theNeonTerminal/Custom-ESP32-Remote-Dev-Board/PowerManagement.png

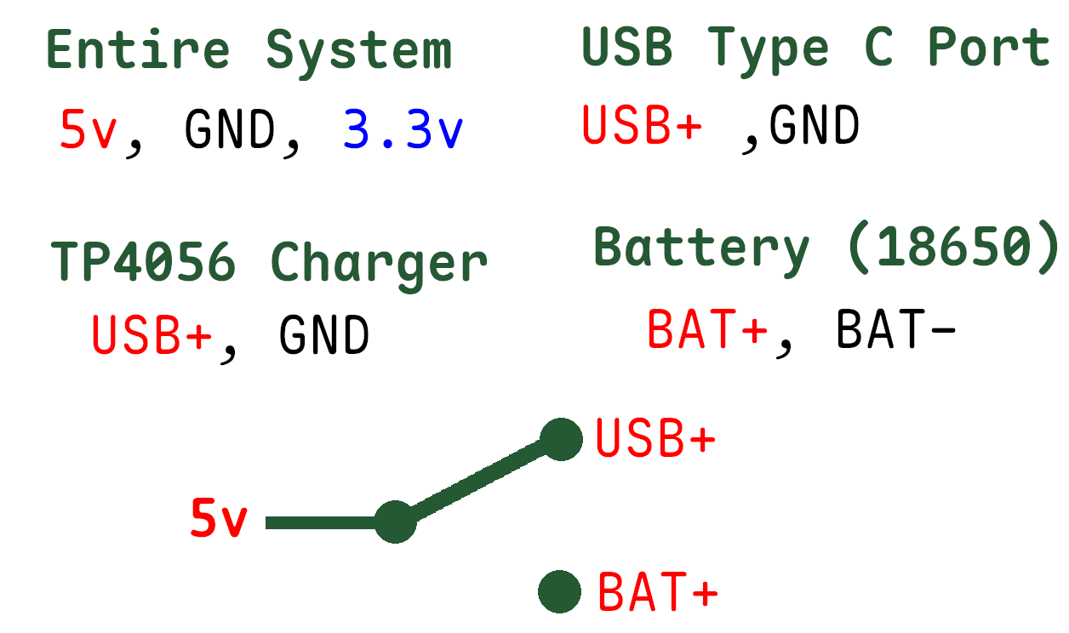
PowerManagement.png
