theNeonTerminal/Custom-ESP32-Remote-Dev-Board/ESP32 RX Board.csv

Reference | Qty | Value | Footprint
C1,C2,C8 | 3 | 10uf | Capacitor_SMD:C_0603_1608Metric_Pad1.08x0.95mm_HandSolder
C3,C4,C6,C7 | 4 | 0.1uf | Capacitor_SMD:C_0603_1608Metric_Pad1.08x0.95mm_HandSolder
C5 | 1 | 4.7uf | Capacitor_SMD:C_0603_1608Metric_Pad1.08x0.95mm_HandSolder
C9,C10 | 2 | 10uf | Capacitor_THT:CP_Radial_D10.0mm_P5.00mm
C11,C_TB1 | 2 | 0.1uf | Capacitor_THT:C_Disc_D3.4mm_W2.1mm_P2.50mm
D1,D2,D3 | 3 | LED | LED_SMD:LED_0603_1608Metric_Pad1.05x0.95mm_HandSolder
J1 | 1 | USB_C_Receptacle_USB2.0_16P | Connector_USB:USB_C_Receptacle_GCT_USB4105-xx-A_16P_TopMnt_Horizontal
J2 | 1 | Conn_01x02_Pin | Connector_PinHeader_2.54mm:PinHeader_1x02_P2.54mm_Vertical
J3 | 1 | Conn_01x02_Socket | TerminalBlock:TerminalBlock_MaiXu_MX126-5.0-02P_1x02_P5.00mm
J4,J5,J6,J7 | 4 | 01x02 | TerminalBlock:TerminalBlock_MaiXu_MX126-5.0-02P_1x02_P5.00mm
J8 | 1 | Conn_01x16_Socket | Connector_PinSocket_2.54mm:PinSocket_1x16_P2.54mm_Vertical
M1,M2,M3,M4 | 4 | Motor_Servo | Connector_PinHeader_2.54mm:PinHeader_1x03_P2.54mm_Vertical
Q1,Q2 | 2 | SS8050 | Package_TO_SOT_SMD:SOT-23
R1,R7 | 2 | 330 | Resistor_SMD:R_0603_1608Metric_Pad0.98x0.95mm_HandSolder
R2,R3 | 2 | 5.1k | Resistor_SMD:R_0603_1608Metric_Pad0.98x0.95mm_HandSolder
R4 | 1 | 47.5k | Resistor_SMD:R_0603_1608Metric_Pad0.98x0.95mm_HandSolder
R5 | 1 | 22.1k | Resistor_SMD:R_0603_1608Metric_Pad0.98x0.95mm_HandSolder
R6,R13 | 2 | 1k | Resistor_SMD:R_0603_1608Metric_Pad0.98x0.95mm_HandSolder
R8,R9,R10,R11,R12 | 5 | 10k | Resistor_SMD:R_0603_1608Metric_Pad0.98x0.95mm_HandSolder
SW1 | 1 | SW_RESET | Button_Switch_SMD:SW_Tactile_SPST_NO_Straight_CK_PTS636Sx25SMTRLFS
SW2 | 1 | SW_BOOT | Button_Switch_SMD:SW_Tactile_SPST_NO_Straight_CK_PTS636Sx25SMTRLFS
U1 | 1 | AMS1117-3.3 | Package_TO_SOT_SMD:SOT-223-3_TabPin2
U2 | 1 | CP2102N-Axx-xQFN28 | Package_DFN_QFN:QFN-28-1EP_5x5mm_P0.5mm_EP3.35x3.35mm
U3 | 1 | USBLC6-2SC6 | Package_TO_SOT_SMD:SOT-23-6
U4 | 1 | ESP32-WROOM-32 | RF_Module:ESP32-WROOM-32
U5 | 1 | L7805 | Package_TO_SOT_THT:TO-220-3_Vertical
U6,U7 | 2 | TB6612FNG | Package_SO:SSOP-24_5.3x8.2mm_P0.65mm
U8 | 1 | 74HC595 | Package_DIP:DIP-16_W7.62mm
