theNeonTerminal/Custom-ESP32-Remote-Dev-Board/ESP32 TX Board.csv

Reference | Qty | Value | Footprint
BT1 | 1 | Battery | Battery:BatteryHolder_MPD_BH-18650-PC
C1,C2,C8,C12 | 4 | 10uf | Capacitor_SMD:C_0603_1608Metric_Pad1.08x0.95mm_HandSolder
C3,C4,C6,C7,C9,C10,C11,C13 | 8 | 0.1uf | Capacitor_SMD:C_0603_1608Metric_Pad1.08x0.95mm_HandSolder
C5 | 1 | 4.7uf | Capacitor_SMD:C_0603_1608Metric_Pad1.08x0.95mm_HandSolder
D2,D5 | 2 | LED | LED_SMD:LED_0603_1608Metric_Pad1.05x0.95mm_HandSolder
DP1,DP2,DP3,DP4 | 4 | SW_Push | Button_Switch_THT:SW_PUSH_6mm
D_G1,D_R1,L1,L2,L3,L4 | 6 | LED | LED_THT:LED_D5.0mm
J1 | 1 | USB_C_Receptacle_USB2.0_16P | Connector_USB:USB_C_Receptacle_GCT_USB4105-xx-A_16P_TopMnt_Horizontal
J2 | 1 | Conn_02x08_Counter_Clockwise | Connector_PinSocket_2.54mm:PinSocket_2x08_P2.54mm_Vertical
Q1,Q2 | 2 | SS8050 | Package_TO_SOT_SMD:SOT-23
Q3 | 1 | FS8205A | FS8205A:SOP65P640X120-8N
R1 | 1 | 330 | Resistor_SMD:R_0603_1608Metric_Pad0.98x0.95mm_HandSolder
R2,R3 | 2 | 5.1k | Resistor_SMD:R_0603_1608Metric_Pad0.98x0.95mm_HandSolder
R4 | 1 | 47.5k | Resistor_SMD:R_0603_1608Metric_Pad0.98x0.95mm_HandSolder
R5 | 1 | 22.1k | Resistor_SMD:R_0603_1608Metric_Pad0.98x0.95mm_HandSolder
R6,R15,R16,R17,R18,R20,R21,R22,R23 | 9 | 1k | Resistor_SMD:R_0603_1608Metric_Pad0.98x0.95mm_HandSolder
R7,R8,R9,R10,R11,R12,R13,R14 | 8 | 10k | Resistor_SMD:R_0603_1608Metric_Pad0.98x0.95mm_HandSolder
R19 | 1 | 100 | Resistor_THT:R_Axial_DIN0309_L9.0mm_D3.2mm_P12.70mm_Horizontal
R24,R25,R26,R27,R28 | 5 | 470 | Resistor_SMD:R_0603_1608Metric_Pad0.98x0.95mm_HandSolder
SW1 | 1 | SW_RESET | Button_Switch_SMD:SW_Tactile_SPST_NO_Straight_CK_PTS636Sx25SMTRLFS
SW2 | 1 | SW_BOOT | Button_Switch_SMD:SW_Tactile_SPST_NO_Straight_CK_PTS636Sx25SMTRLFS
SW3 | 1 | SW_SPDT | Button_Switch_THT:SW_Slide-03_Wuerth-WS-SLTV_10x2.5x6.4_P2.54mm
U1 | 1 | AMS1117-3.3 | Package_TO_SOT_SMD:SOT-223-3_TabPin2
U2 | 1 | CP2102N-Axx-xQFN28 | Package_DFN_QFN:QFN-28-1EP_5x5mm_P0.5mm_EP3.35x3.35mm
U3 | 1 | USBLC6-2SC6 | Package_TO_SOT_SMD:SOT-23-6
U4 | 1 | ESP32-WROOM-32 | RF_Module:ESP32-WROOM-32
U5 | 1 | ADS1115IDGS | Package_SO:TSSOP-10_3x3mm_P0.5mm
U6,U7 | 2 | Joystick | Joystick:JoyStick
U8 | 1 | TP4056 | Package_SO:SOIC-8-1EP_3.9x4.9mm_P1.27mm_EP2.41x3.3mm_ThermalVias
U9 | 1 | DW01A | DW01A:SOT95P280X145-6N
