theNeonTerminal/Custom-ESP32-Remote-Dev-Board/ESP32_RX_Board/View/schematic.pdf

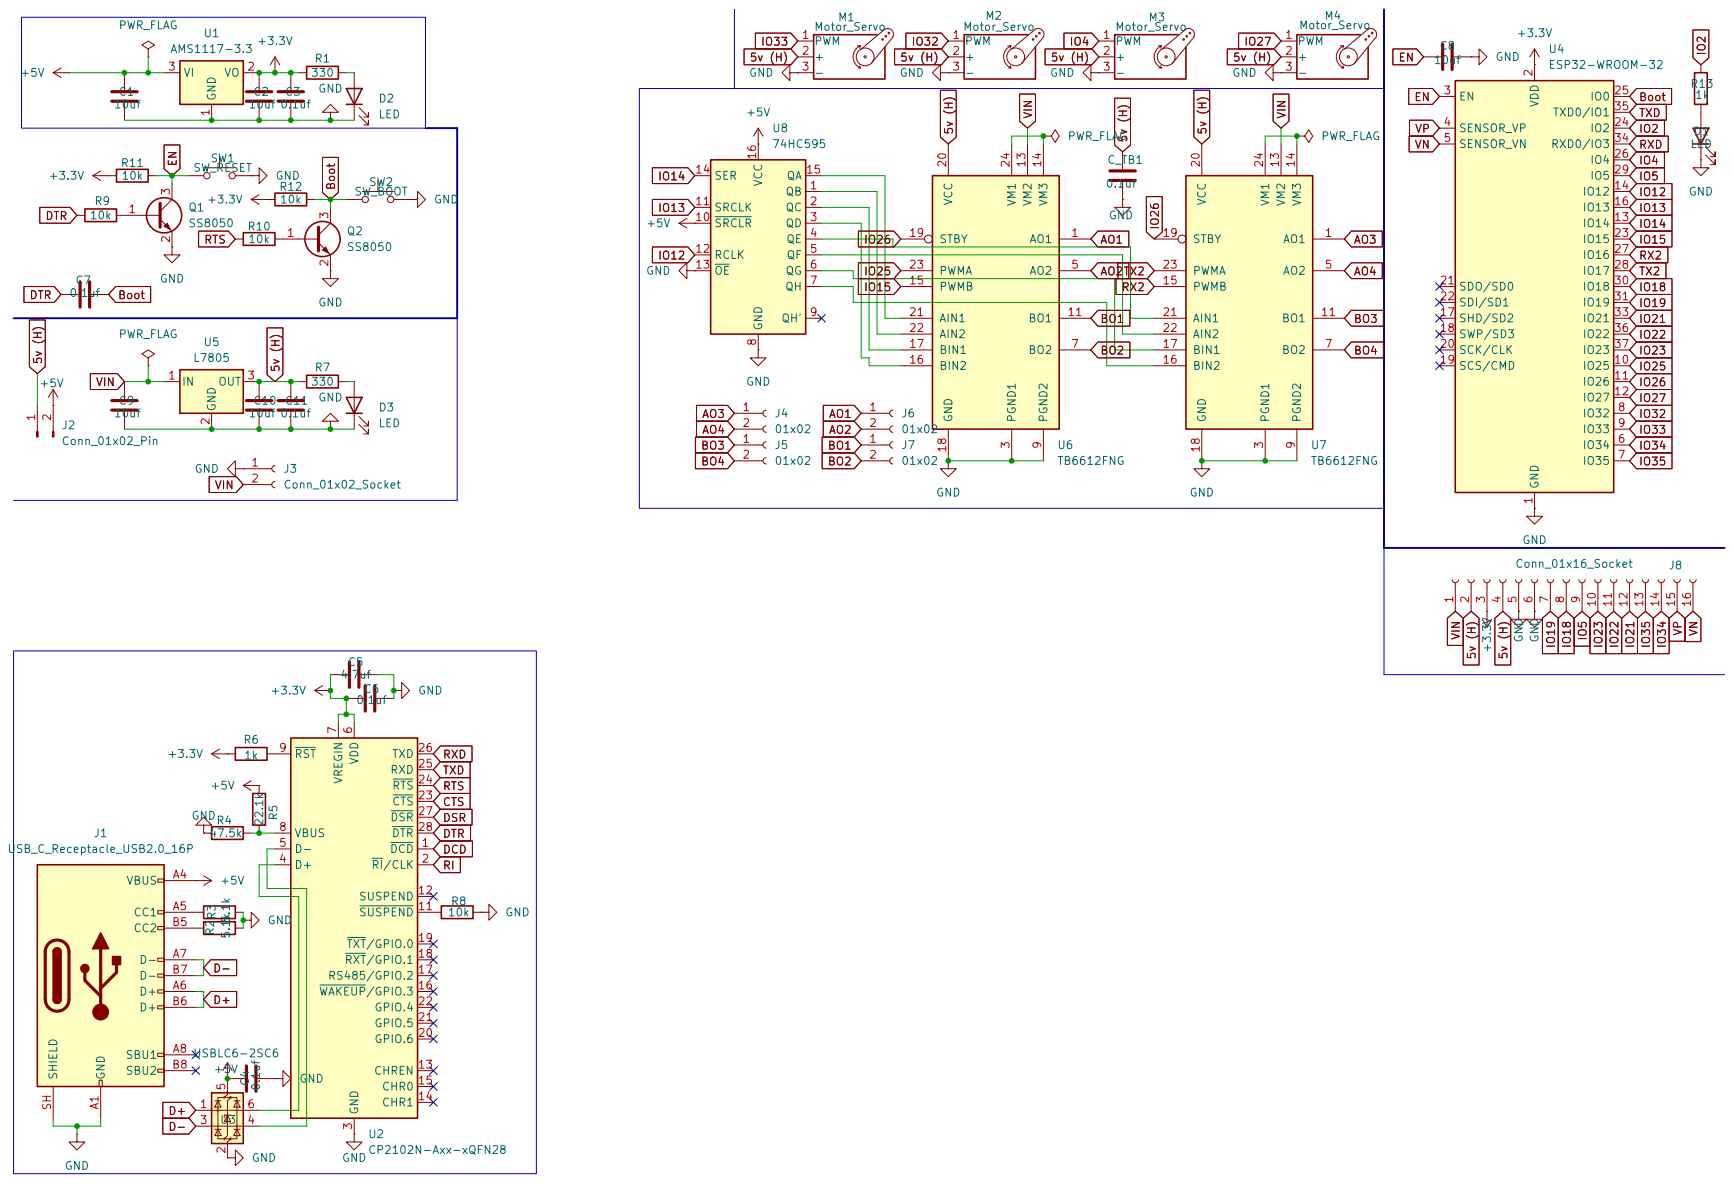
[picture p6: page 1]
