theNeonTerminal/Custom-ESP32-Remote-Dev-Board/ESP32_TX_Board/View/schematic.pdf

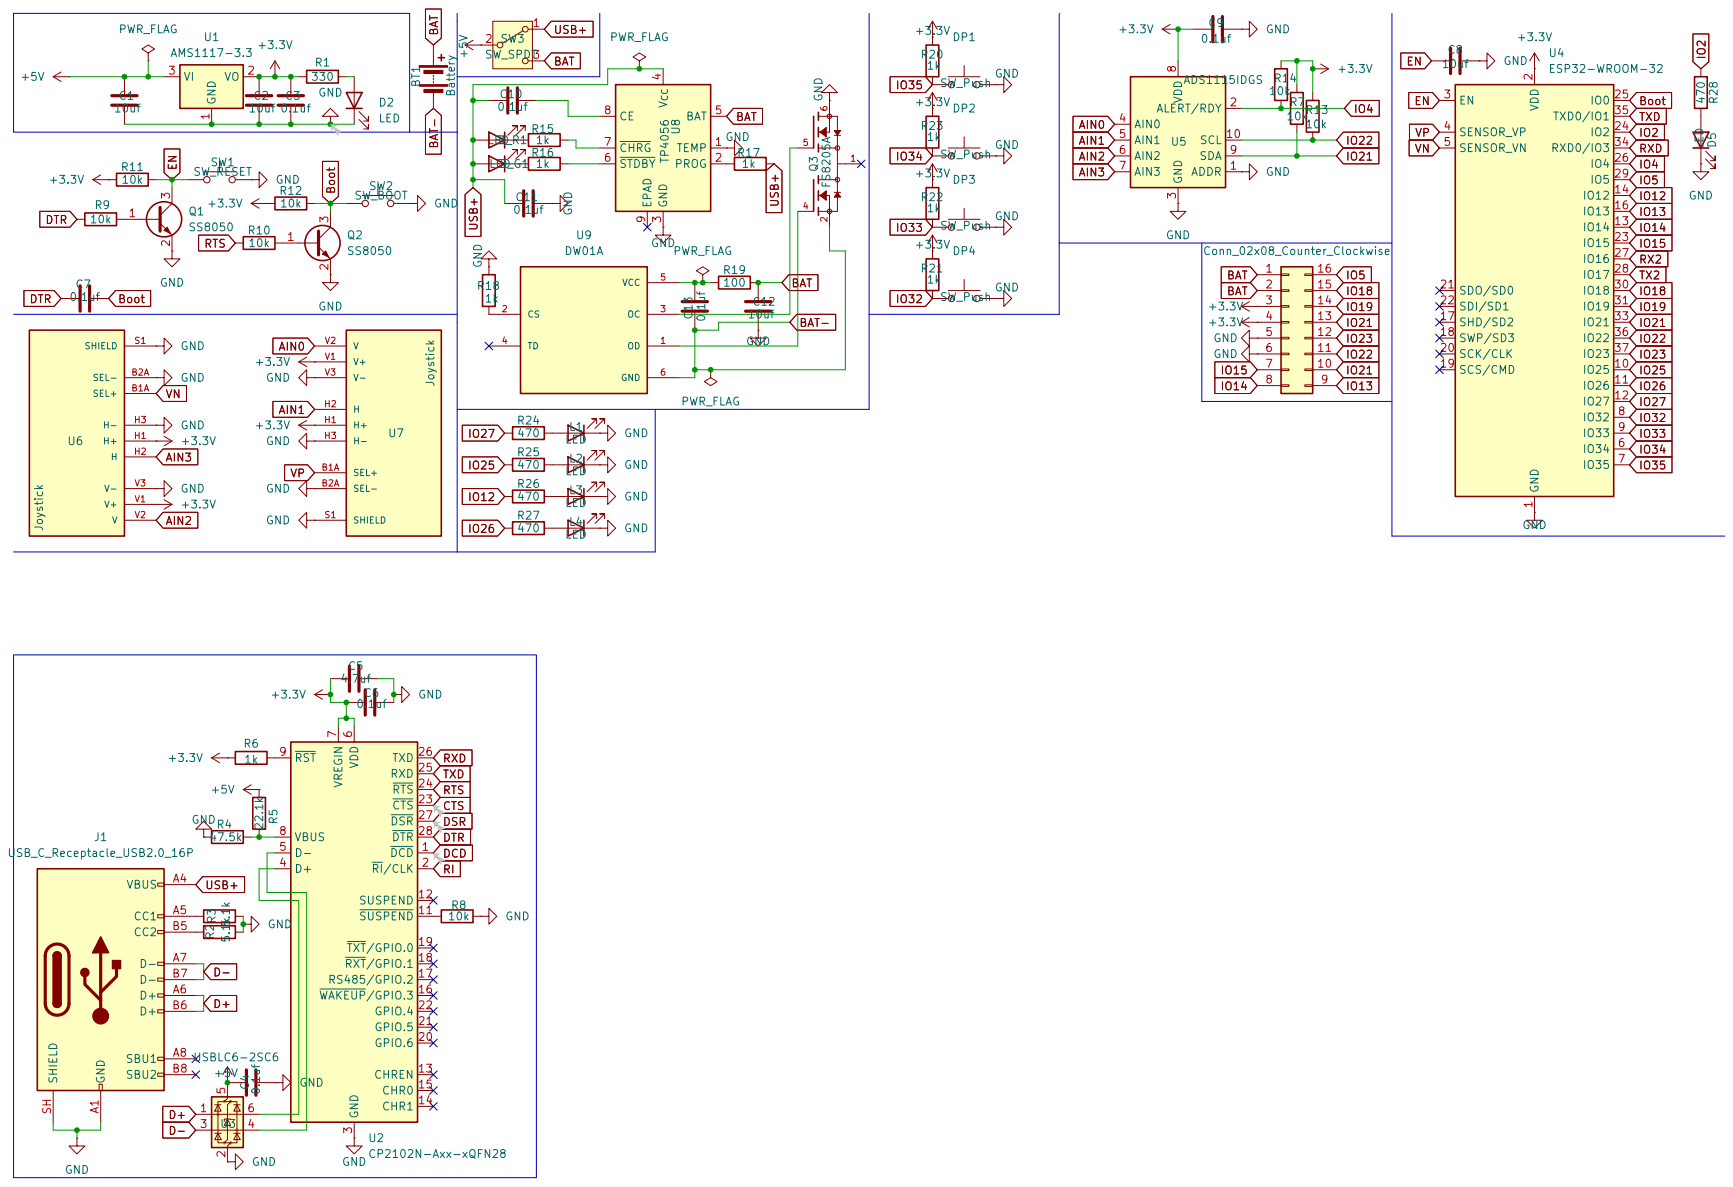
[picture p7: page 1]
