theNeonTerminal/Custom-ESP32-Remote-Dev-Board/ESP32_RX_Board/View/footprint.pdf

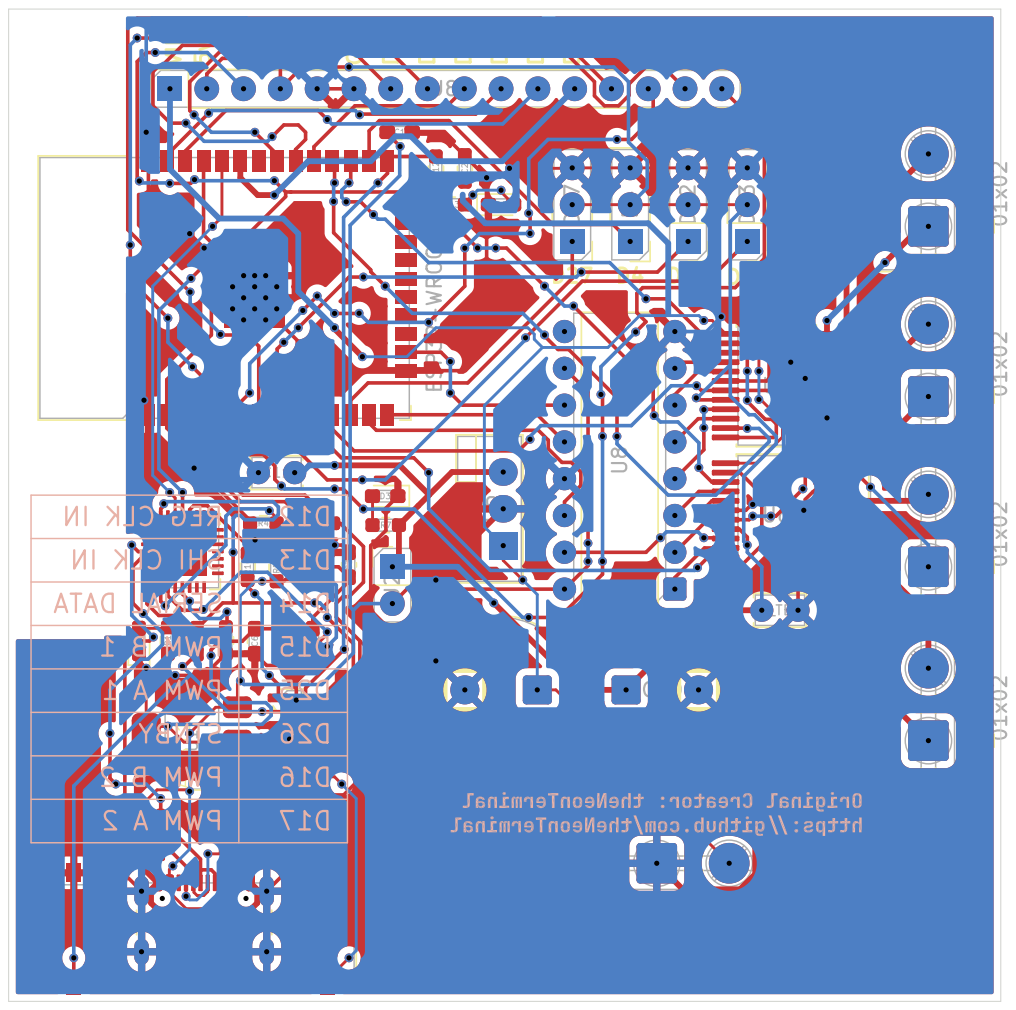
[picture p8: page 1]
