theNeonTerminal/Custom-ESP32-Remote-Dev-Board/ESP32_TX_Board/View/PCB.pdf

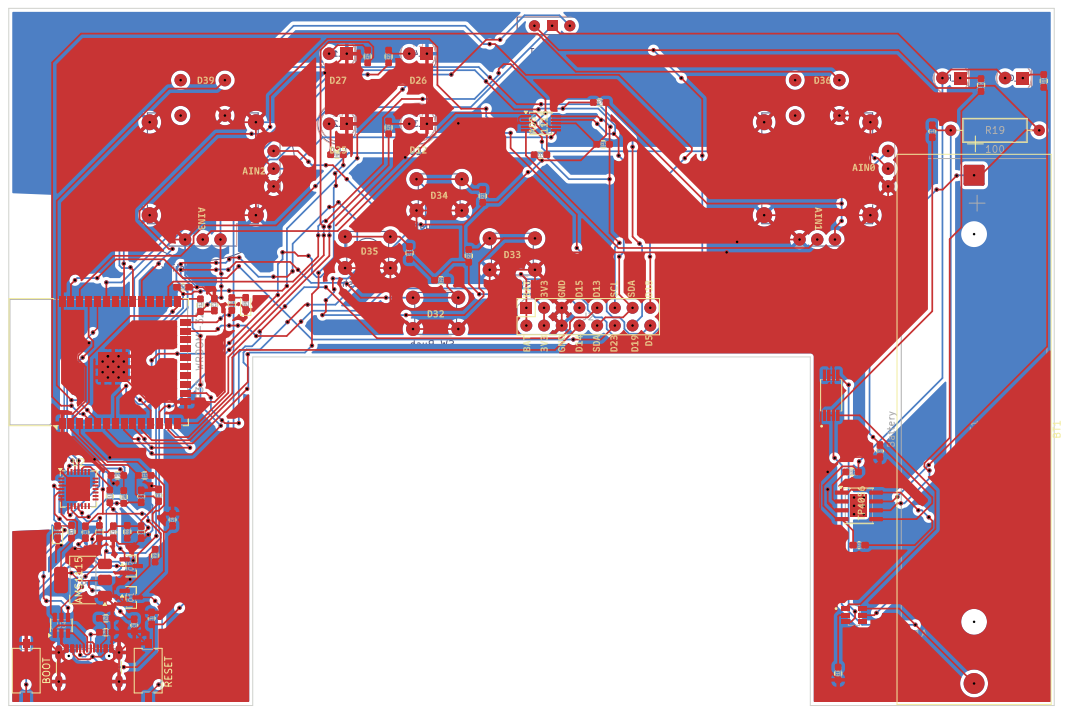
[picture p9: page 1]
