theNeonTerminal/Custom-ESP32-Remote-Dev-Board/ESP32_RX_Board/ESP32 RX Board.kicad_pcb

## KiCad design ESP32_RX_Board/ESP32 RX Board.kicad_pcb (2026-11-11)

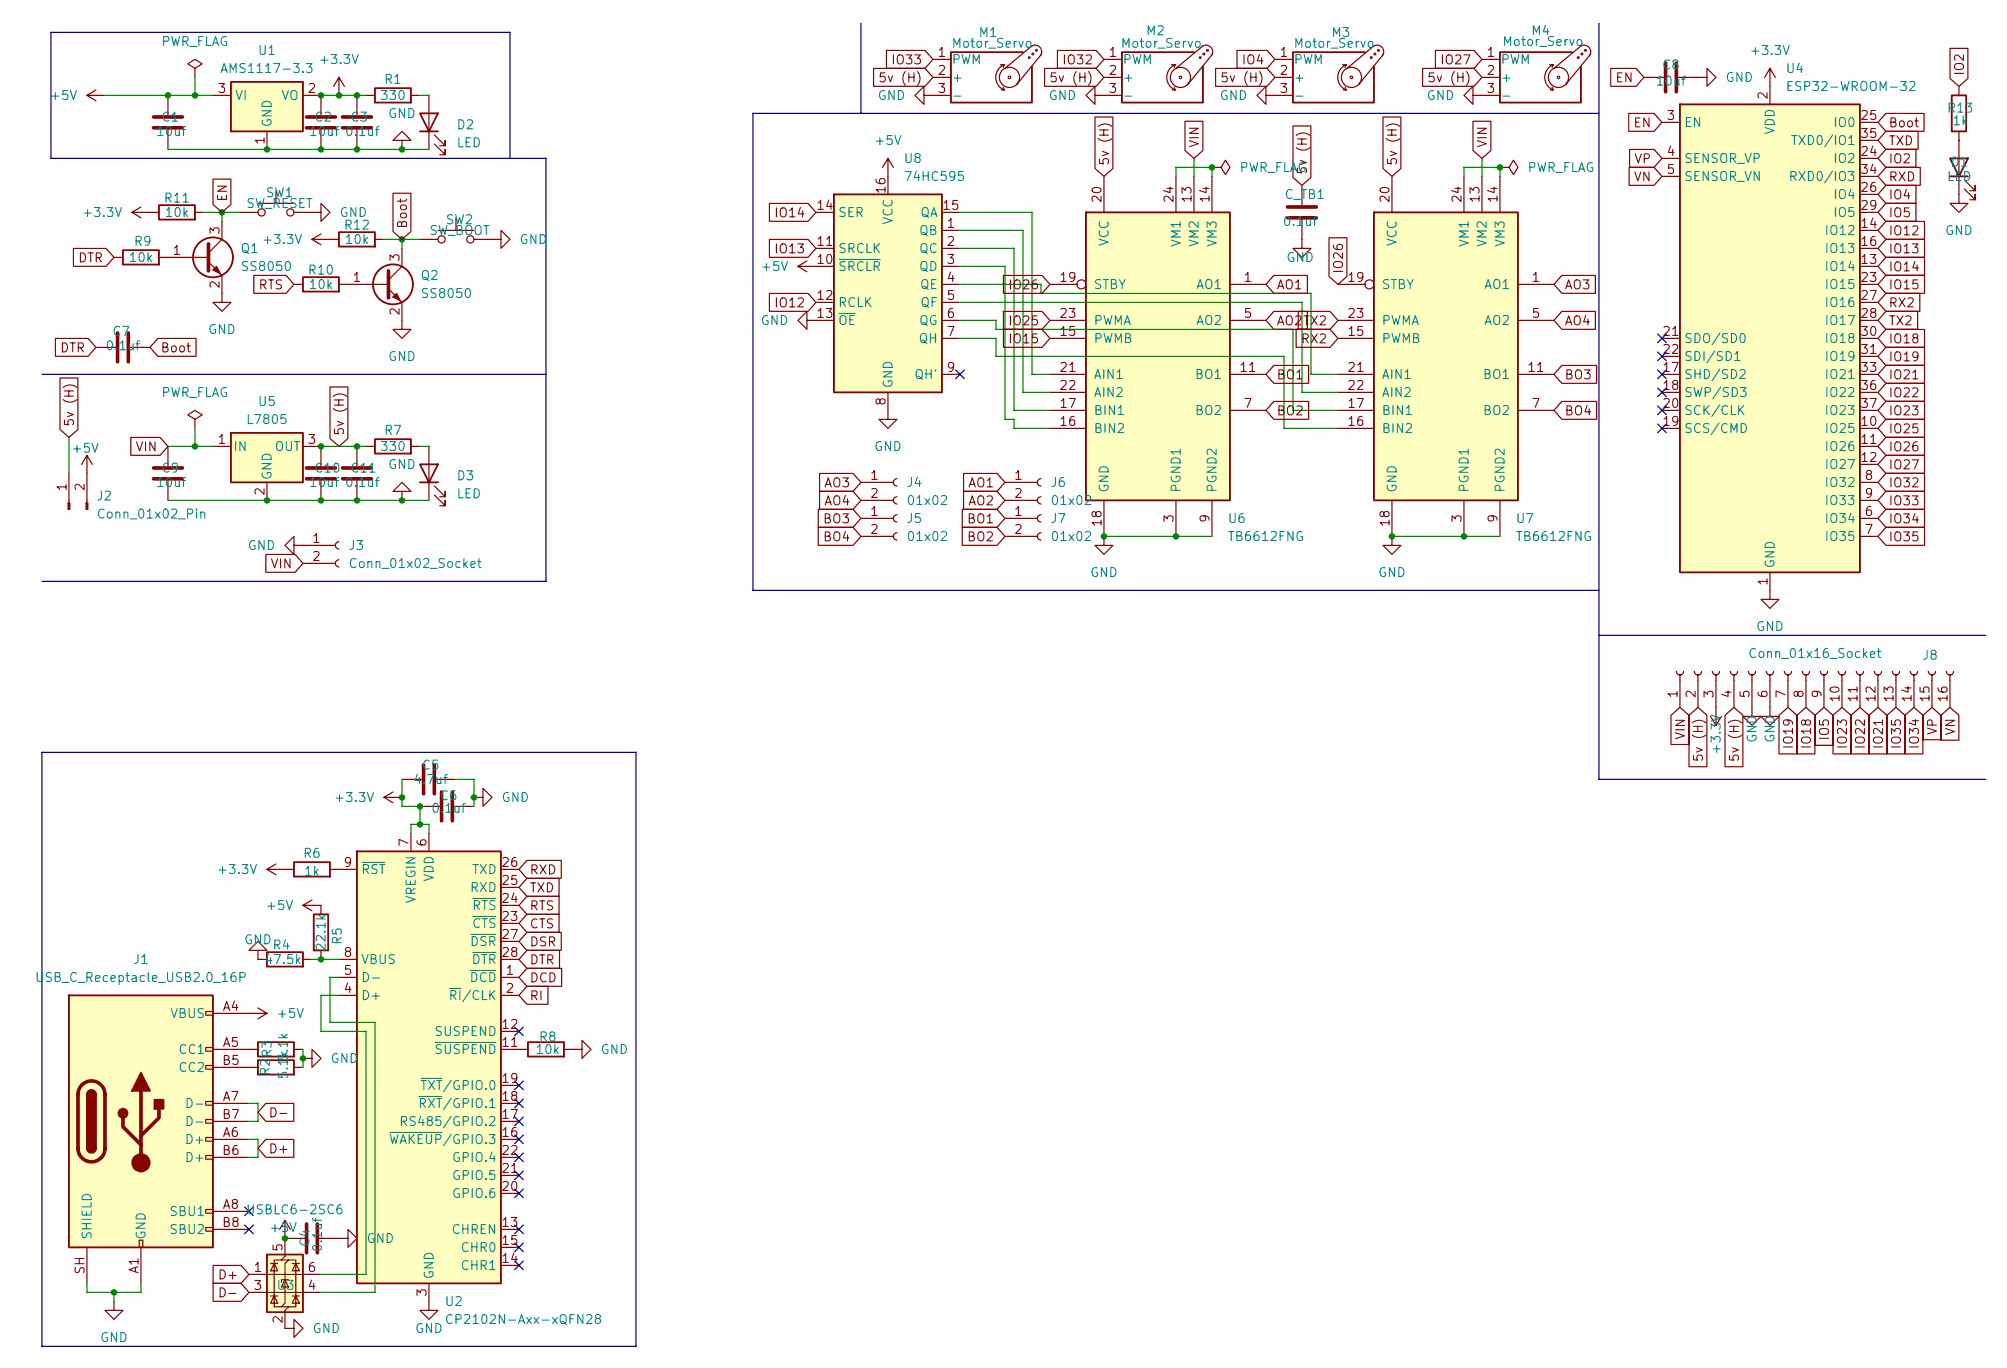
[picture p10: schematic ESP32 RX Board.kicad_sch]

Parts:
C1, C2, C8: 10uf; C_0603_1608Metric_Pad1.08x0.95mm_HandSolder
C3, C4, C6, C7: 0.1uf; C_0603_1608Metric_Pad1.08x0.95mm_HandSolder
C5: 4.7uf; C_0603_1608Metric_Pad1.08x0.95mm_HandSolder
C9, C10: 10uf; CP_Radial_D10.0mm_P5.00mm
C11: 0.1uf; C_Disc_D3.4mm_W2.1mm_P2.50mm
C_TB1: 0.1uf; C_Disc_D3.4mm_W2.1mm_P2.50mm
D1, D2, D3: LED; LED_0603_1608Metric_Pad1.05x0.95mm_HandSolder
J1: USB_C_Receptacle_USB2.0_16P; USB_C_Receptacle_GCT_USB4105-xx-A_16P_TopMnt_Horizontal
J2: Conn_01x02_Pin; PinHeader_1x02_P2.54mm_Vertical
J3: Conn_01x02_Socket; TerminalBlock_MaiXu_MX126-5.0-02P_1x02_P5.00mm
J4, J5, J6, J7: 01x02; TerminalBlock_MaiXu_MX126-5.0-02P_1x02_P5.00mm
J8: Conn_01x16_Socket; PinSocket_1x16_P2.54mm_Vertical
M1, M2, M3, M4: Motor_Servo; PinHeader_1x03_P2.54mm_Vertical
Q1, Q2: SS8050; SOT-23
R1, R7: 330; R_0603_1608Metric_Pad0.98x0.95mm_HandSolder
R2, R3: 5.1k; R_0603_1608Metric_Pad0.98x0.95mm_HandSolder
R4: 47.5k; R_0603_1608Metric_Pad0.98x0.95mm_HandSolder
R5: 22.1k; R_0603_1608Metric_Pad0.98x0.95mm_HandSolder
R6, R13: 1k; R_0603_1608Metric_Pad0.98x0.95mm_HandSolder
R8, R9, R10, R11, R12: 10k; R_0603_1608Metric_Pad0.98x0.95mm_HandSolder
SW1: SW_RESET; SW_Tactile_SPST_NO_Straight_CK_PTS636Sx25SMTRLFS
SW2: SW_BOOT; SW_Tactile_SPST_NO_Straight_CK_PTS636Sx25SMTRLFS
U1: AMS1117-3.3; SOT-223-3_TabPin2
U2: CP2102N-Axx-xQFN28; QFN-28-1EP_5x5mm_P0.5mm_EP3.35x3.35mm
U3: USBLC6-2SC6; SOT-23-6
U4: ESP32-WROOM-32
U5: L7805; TO-220-3_Vertical
U6, U7: TB6612FNG; SSOP-24_5.3x8.2mm_P0.65mm
U8: 74HC595; DIP-16_W7.62mm

Connections:
5v (H): C10.1, C11.1, C_TB1.1, J2.1, J8.2, J8.4, M1.2 (+), M2.2 (+), M3.2 (+), M4.2 (+), R7.1, U5.3 (OUT), U6.20 (VCC), U7.20 (VCC); also elsewhere on the board
+3.3V: C2.1, C3.1, C5.1, C6.1, J8.3, R1.1, R6.1, R11.1, R12.1, U1.2 (VO), U2.6 (VDD), U2.7 (VREGIN), U4.2 (VDD)
+5V: C1.1, C4.1, J1.A4 (VBUS), J1.A9 (VBUS), J1.B4 (VBUS), J1.B9 (VBUS), J2.2, R5.1, U1.3 (VI), U3.5 (VBUS), U8.10 (~SRCLR), U8.16 (VCC)
AO1: J6.1, U6.1 (AO1), U6.2 (AO1)
AO2: J6.2, U6.5 (AO2), U6.6 (AO2)
AO3: J4.1, U7.1 (AO1), U7.2 (AO1)
AO4: J4.2, U7.5 (AO2), U7.6 (AO2)
BO1: J7.1, U6.11 (BO1), U6.12 (BO1)
BO2: J7.2, U6.7 (BO2), U6.8 (BO2)
BO3: J5.1, U7.11 (BO1), U7.12 (BO1)
BO4: J5.2, U7.7 (BO2), U7.8 (BO2)
Boot: C7.2, Q2.3 (C), R12.2, SW2.1, U4.25 (IO0)
CTS: U2.23 (~CTS)
D+: J1.A6 (D+), J1.B6 (D+), U3.1 (I/O1)
D-: J1.A7 (D-), J1.B7 (D-), U3.3 (I/O2)
DCD: U2.1 (~DCD)
DSR: U2.27 (~DSR)
DTR: C7.1, R9.1, U2.28 (~DTR)
EN: C8.1, Q1.3 (C), R11.2, SW1.1, U4.3 (EN)
GND: C1.2, C2.2, C3.2, C4.2, C5.2, C6.2, C8.2, C9.2, C10.2, C11.2, C_TB1.2, D1.1 (K), D2.1 (K), D3.1 (K), J1.A1 (GND), J1.A12 (GND), J1.B1 (GND), J1.B12 (GND), J1.SH (SHIELD), J3.1, J8.5, J8.6, M1.3 (-), M2.3 (-), M3.3 (-), M4.3 (-), Q1.2 (E), Q2.2 (E), R2.2, R3.2, R4.1, R8.2, SW1.2, SW2.2, U1.1 (GND), U2.3 (GND), U2.29 (GND), U3.2 (GND), U4.1 (GND), U4.15 (GND), U4.38 (GND), U4.39 (GND), U5.2 (GND), U6.3 (PGND1), U6.4 (PGND1), U6.9 (PGND2), U6.10 (PGND2), U6.18 (GND), U7.3 (PGND1), U7.4 (PGND1), U7.9 (PGND2), U7.10 (PGND2), U7.18 (GND), U8.8 (GND), U8.13 (~OE); also elsewhere on the board
IO2: R13.1, U4.24 (IO2)
IO4: M3.1 (PWM), U4.26 (IO4); also elsewhere on the board
IO5: J8.9, U4.29 (IO5)
IO12: U4.14 (IO12), U8.12 (RCLK)
IO13: U4.16 (IO13), U8.11 (SRCLK)
IO14: U4.13 (IO14), U8.14 (SER)
IO15: U4.23 (IO15), U6.15 (PWMB)
IO18: J8.8, U4.30 (IO18)
IO19: J8.7, U4.31 (IO19)
IO21: J8.12, U4.33 (IO21)
IO22: J8.11, U4.36 (IO22)
IO23: J8.10, U4.37 (IO23)
IO25: U4.10 (IO25), U6.23 (PWMA)
IO26: U4.11 (IO26), U6.19 (STBY), U7.19 (STBY)
IO27: M4.1 (PWM), U4.12 (IO27); also elsewhere on the board
IO32: M2.1 (PWM), U4.8 (IO32); also elsewhere on the board
IO33: M1.1 (PWM), U4.9 (IO33); also elsewhere on the board
IO34: J8.14, U4.6 (IO34)
IO35: J8.13, U4.7 (IO35)
unnamed: D1.2 (A), R13.2
unnamed: D2.2 (A), R1.2
unnamed: D3.2 (A), R7.2
unnamed: J1.A5 (CC1), R3.1
unnamed: J1.B5 (CC2), R2.1
unnamed: Q1.1 (B), R9.2
unnamed: Q2.1 (B), R10.2
unnamed: U2.4 (D+), U3.6 (I/O1)
unnamed: U2.5 (D-), U3.4 (I/O2)
unnamed: R4.2, R5.2, U2.8 (VBUS)
unnamed: R6.2, U2.9 (~RST)
unnamed: R8.1, U2.11 (~SUSPEND)
unnamed: U6.21 (AIN1), U8.15 (QA)
unnamed: U6.22 (AIN2), U8.1 (QB)
unnamed: U6.17 (BIN1), U8.2 (QC)
unnamed: U6.16 (BIN2), U8.3 (QD)
unnamed: U6.14 (VM3), U6.24 (VM1)
unnamed: U7.21 (AIN1), U8.4 (QE)
unnamed: U7.22 (AIN2), U8.5 (QF)
unnamed: U7.17 (BIN1), U8.6 (QG)
unnamed: U7.16 (BIN2), U8.7 (QH)
unnamed: U7.14 (VM3), U7.24 (VM1)
RI: U2.2 (~RI/CLK)
RTS: R10.1, U2.24 (~RTS)
RX2: U4.27 (IO16), U7.15 (PWMB)
RXD: U2.26 (TXD), U4.34 (RXD0/IO3)
TX2: U4.28 (IO17), U7.23 (PWMA)
TXD: U2.25 (RXD), U4.35 (TXD0/IO1)
VIN: C9.1, J3.2, J8.1, U5.1 (IN), U6.13 (VM2), U7.13 (VM2)
VN: J8.16, U4.5 (SENSOR_VN)
VP: J8.15, U4.4 (SENSOR_VP)

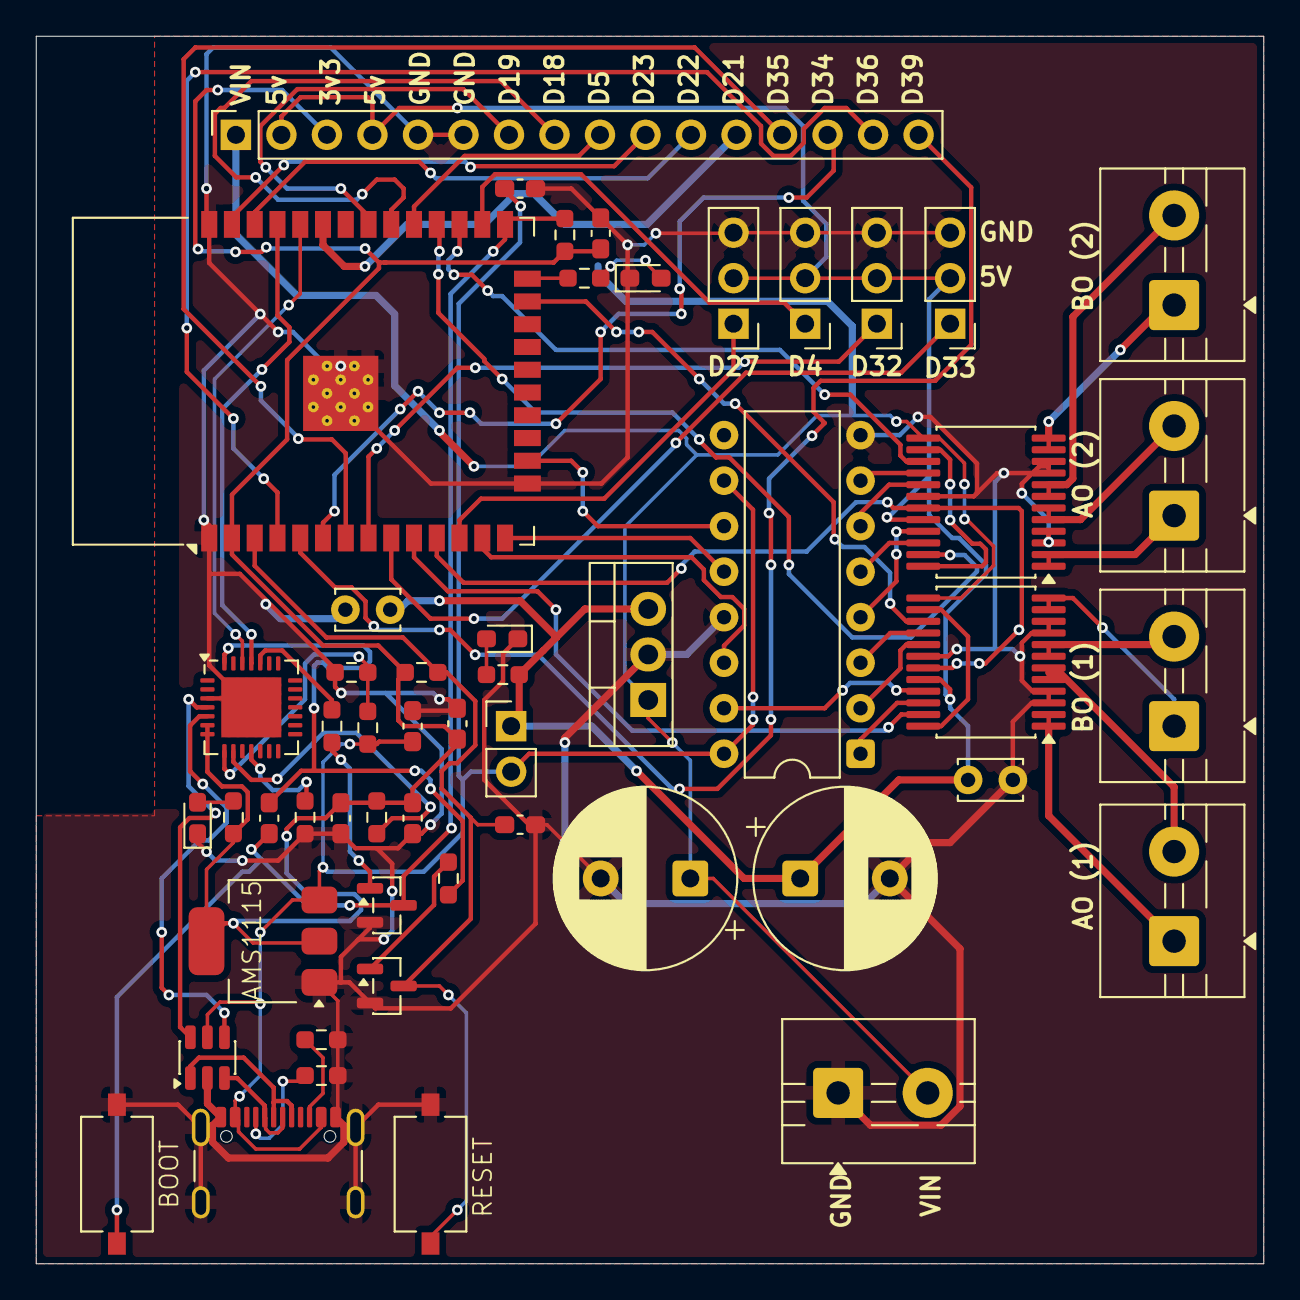
[picture p11: board ESP32 RX Board.kicad_pcb from above]

Board: 2 copper layers, 68.5 x 68.5 mm, 52 parts (0 on the bottom side), 66 nets.

Other parts of the board:
D4, D27, D32, D33: Motor_Servo; PinHeader_1x03_P2.54mm_Vertical

Their connections:
5v (H): D4.2 (+), D27.2 (+), D32.2 (+), D33.2 (+); also elsewhere on the board
GND: D4.3 (-), D27.3 (-), D32.3 (-), D33.3 (-); also elsewhere on the board
IO4: D4.1 (PWM); also elsewhere on the board
IO27: D27.1 (PWM); also elsewhere on the board
IO32: D32.1 (PWM); also elsewhere on the board
IO33: D33.1 (PWM); also elsewhere on the board
