theNeonTerminal/Custom-ESP32-Remote-Dev-Board/ESP32_TX_Board/ESP32 TX Board.kicad_pcb

## KiCad design ESP32_TX_Board/ESP32 TX Board.kicad_pcb (2026-11-13)

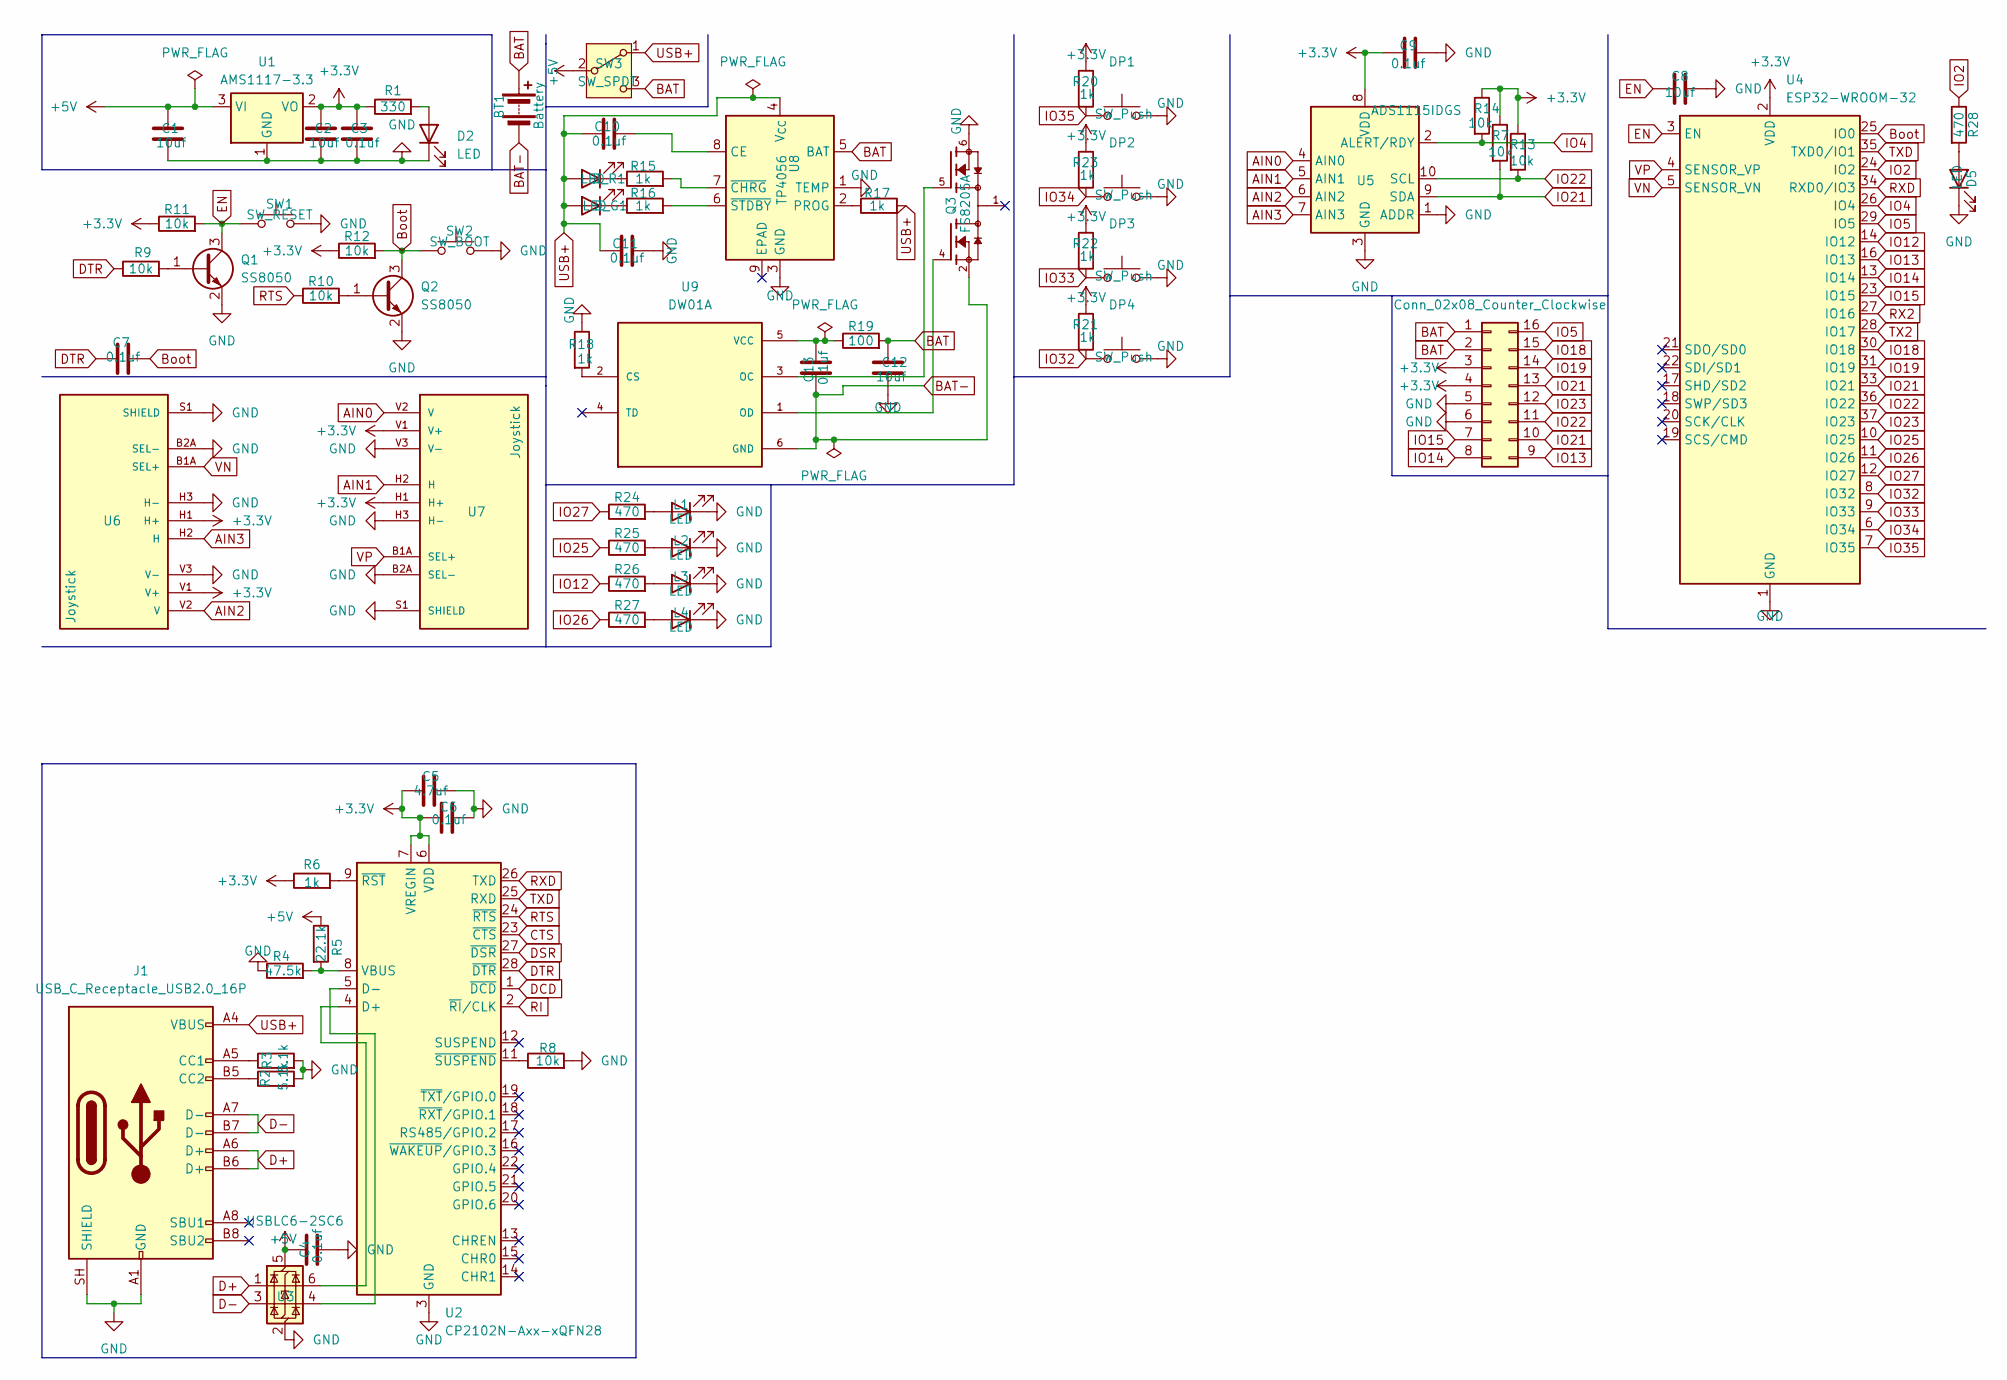
[picture p12: schematic ESP32 TX Board.kicad_sch]

Parts:
BT1: Battery; BatteryHolder_MPD_BH-18650-PC
C1, C2, C8, C12: 10uf; C_0603_1608Metric_Pad1.08x0.95mm_HandSolder
C3, C4, C6, C7, C9, C10, C11, C13: 0.1uf; C_0603_1608Metric_Pad1.08x0.95mm_HandSolder
C5: 4.7uf; C_0603_1608Metric_Pad1.08x0.95mm_HandSolder
D2, D5: LED; LED_0603_1608Metric_Pad1.05x0.95mm_HandSolder
DP1, DP2, DP3, DP4: SW_Push; SW_PUSH_6mm
D_G1: LED; LED_D5.0mm
D_R1: LED; LED_D5.0mm
J1: USB_C_Receptacle_USB2.0_16P; USB_C_Receptacle_GCT_USB4105-xx-A_16P_TopMnt_Horizontal
J2: Conn_02x08_Counter_Clockwise; PinSocket_2x08_P2.54mm_Vertical
L1, L2, L3, L4: LED; LED_D5.0mm
Q1, Q2: SS8050; SOT-23
Q3: FS8205A; SOP65P640X120-8N; MPN FS8205A
R1: 330; R_0603_1608Metric_Pad0.98x0.95mm_HandSolder
R2, R3: 5.1k; R_0603_1608Metric_Pad0.98x0.95mm_HandSolder
R4: 47.5k; R_0603_1608Metric_Pad0.98x0.95mm_HandSolder
R5: 22.1k; R_0603_1608Metric_Pad0.98x0.95mm_HandSolder
R6, R15, R16, R17, R18, R20, R21, R22, R23: 1k; R_0603_1608Metric_Pad0.98x0.95mm_HandSolder
R7, R8, R9, R10, R11, R12, R13, R14: 10k; R_0603_1608Metric_Pad0.98x0.95mm_HandSolder
R19: 100; R_Axial_DIN0309_L9.0mm_D3.2mm_P12.70mm_Horizontal
R24, R25, R26, R27, R28: 470; R_0603_1608Metric_Pad0.98x0.95mm_HandSolder
SW1: SW_RESET; SW_Tactile_SPST_NO_Straight_CK_PTS636Sx25SMTRLFS
SW2: SW_BOOT; SW_Tactile_SPST_NO_Straight_CK_PTS636Sx25SMTRLFS
SW3: SW_SPDT; SW_Slide-03_Wuerth-WS-SLTV_10x2.5x6.4_P2.54mm
U1: AMS1117-3.3; SOT-223-3_TabPin2
U2: CP2102N-Axx-xQFN28; QFN-28-1EP_5x5mm_P0.5mm_EP3.35x3.35mm
U3: USBLC6-2SC6; SOT-23-6
U4: ESP32-WROOM-32
U5: ADS1115IDGS; TSSOP-10_3x3mm_P0.5mm
U6, U7: Joystick; JoyStick; PARTREV N/A
U8: TP4056; SOIC-8-1EP_3.9x4.9mm_P1.27mm_EP2.41x3.3mm_ThermalVias
U9: DW01A; SOT95P280X145-6N; MPN DW01A

Connections:
+3.3V: C2.1, C3.1, C5.1, C6.1, C9.2, J2.3, J2.4, R1.1, R6.1, R7.1, R11.1, R12.1, R13.1, R14.1, R20.1, R21.1, R22.1, R23.1, U1.2 (VO), U2.6 (VDD), U2.7 (VREGIN), U4.2 (VDD), U5.8 (VDD), U6.H1 (H+), U6.V1 (V+), U7.H1 (H+), U7.V1 (V+)
+5V: C1.1, C4.1, R5.1, SW3.2 (B), U1.3 (VI), U3.5 (VBUS)
AIN0: U5.4 (AIN0), U7.V2 (V)
AIN1: U5.5 (AIN1), U7.H2 (H)
AIN2: U5.6 (AIN2), U6.V2 (V)
AIN3: U5.7 (AIN3), U6.H2 (H)
BAT: BT1.1 (+), C12.1, J2.1, J2.2, R19.2, SW3.3 (C), U8.5 (BAT)
BAT-: BT1.2 (-), C13.1, Q3.2, Q3.3, U9.6 (GND)
Boot: C7.2, Q2.3 (C), R12.2, SW2.1, U4.25 (IO0)
CTS: U2.23 (~CTS)
D+: J1.A6 (D+), J1.B6 (D+), U3.1 (I/O1)
D-: J1.A7 (D-), J1.B7 (D-), U3.3 (I/O2)
DCD: U2.1 (~DCD)
DSR: U2.27 (~DSR)
DTR: C7.1, R9.1, U2.28 (~DTR)
EN: C8.1, Q1.3 (C), R11.2, SW1.1, U4.3 (EN)
GND: C1.2, C2.2, C3.2, C4.2, C5.2, C6.2, C8.2, C9.1, C11.2, C12.2, D2.1 (K), D5.1 (K), DP1.2, DP2.2, DP3.2, DP4.2, J1.A1 (GND), J1.A12 (GND), J1.B1 (GND), J1.B12 (GND), J1.SH (SHIELD), J2.5, J2.6, L1.1 (K), L2.1 (K), L3.1 (K), L4.1 (K), Q1.2 (E), Q2.2 (E), Q3.6, Q3.7, R2.2, R3.2, R4.1, R8.2, R18.1, SW1.2, SW2.2, U1.1 (GND), U2.3 (GND), U2.29 (GND), U3.2 (GND), U4.1 (GND), U4.15 (GND), U4.38 (GND), U4.39 (GND), U5.1 (ADDR), U5.3 (GND), U6.B2A (SEL-), U6.H3 (H-), U6.S1 (SHIELD), U6.S2 (SHIELD), U6.S3 (SHIELD), U6.S4 (SHIELD), U6.V3 (V-), U7.B2A (SEL-), U7.H3 (H-), U7.S1 (SHIELD), U7.S2 (SHIELD), U7.S3 (SHIELD), U7.S4 (SHIELD), U7.V3 (V-), U8.1 (TEMP), U8.3 (GND)
IO2: R28.1, U4.24 (IO2)
IO4: R14.2, U4.26 (IO4), U5.2 (ALERT/RDY)
IO5: J2.16, U4.29 (IO5)
IO12: R26.1, U4.14 (IO12)
IO13: J2.9, U4.16 (IO13)
IO14: J2.8, U4.13 (IO14)
IO15: J2.7, U4.23 (IO15)
IO18: J2.15, U4.30 (IO18)
IO19: J2.14, U4.31 (IO19)
IO21: J2.10, J2.13, R7.2, U4.33 (IO21), U5.9 (SDA)
IO22: J2.11, R13.2, U4.36 (IO22), U5.10 (SCL)
IO23: J2.12, U4.37 (IO23)
IO25: R25.1, U4.10 (IO25)
IO26: R27.1, U4.11 (IO26)
IO27: R24.1, U4.12 (IO27)
IO32: DP4.1, R21.2, U4.8 (IO32)
IO33: DP3.1, R22.2, U4.9 (IO33)
IO34: DP2.1, R23.2, U4.6 (IO34)
IO35: DP1.1, R20.2, U4.7 (IO35)
unnamed: D2.2 (A), R1.2
unnamed: D5.2 (A), R28.2
unnamed: D_G1.1 (K), R15.1
unnamed: D_R1.1 (K), R16.1
unnamed: J1.A5 (CC1), R3.1
unnamed: J1.B5 (CC2), R2.1
unnamed: L1.2 (A), R24.2
unnamed: L2.2 (A), R25.2
unnamed: L3.2 (A), R26.2
unnamed: L4.2 (A), R27.2
unnamed: Q1.1 (B), R9.2
unnamed: Q2.1 (B), R10.2
unnamed: U2.4 (D+), U3.6 (I/O1)
unnamed: U2.5 (D-), U3.4 (I/O2)
unnamed: R4.2, R5.2, U2.8 (VBUS)
unnamed: R6.2, U2.9 (~RST)
unnamed: R8.1, U2.11 (~SUSPEND)
unnamed: C10.2, U8.8 (CE)
unnamed: R17.1, U8.2 (PROG)
unnamed: R15.2, U8.7 (~CHRG)
unnamed: R16.2, U8.6 (~STDBY)
unnamed: R18.2, U9.2 (CS)
unnamed: Q3.5, U9.3 (OC)
unnamed: Q3.4, U9.1 (OD)
unnamed: C13.2, R19.1, U9.5 (VCC)
RI: U2.2 (~RI/CLK)
RTS: R10.1, U2.24 (~RTS)
RX2: U4.27 (IO16)
RXD: U2.26 (TXD), U4.34 (RXD0/IO3)
TX2: U4.28 (IO17)
TXD: U2.25 (RXD), U4.35 (TXD0/IO1)
USB+: C10.1, C11.1, D_G1.2 (A), D_R1.2 (A), J1.A4 (VBUS), J1.A9 (VBUS), J1.B4 (VBUS), J1.B9 (VBUS), R17.2, SW3.1 (A), U8.4 (V_{CC})
VN: U4.5 (SENSOR_VN), U6.B1A (SEL+)
VP: U4.4 (SENSOR_VP), U7.B1A (SEL+)

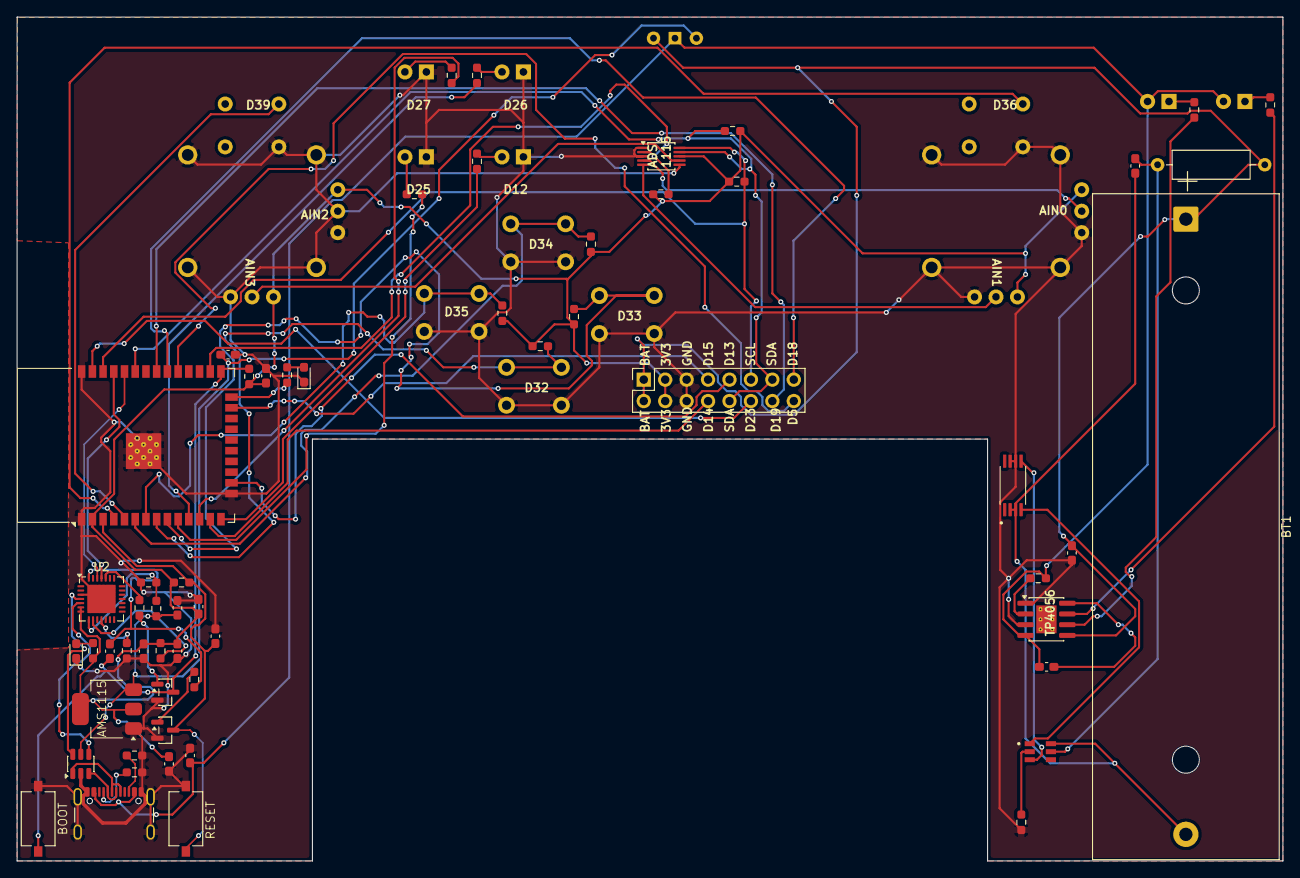
[picture p13: board ESP32 TX Board.kicad_pcb from above]

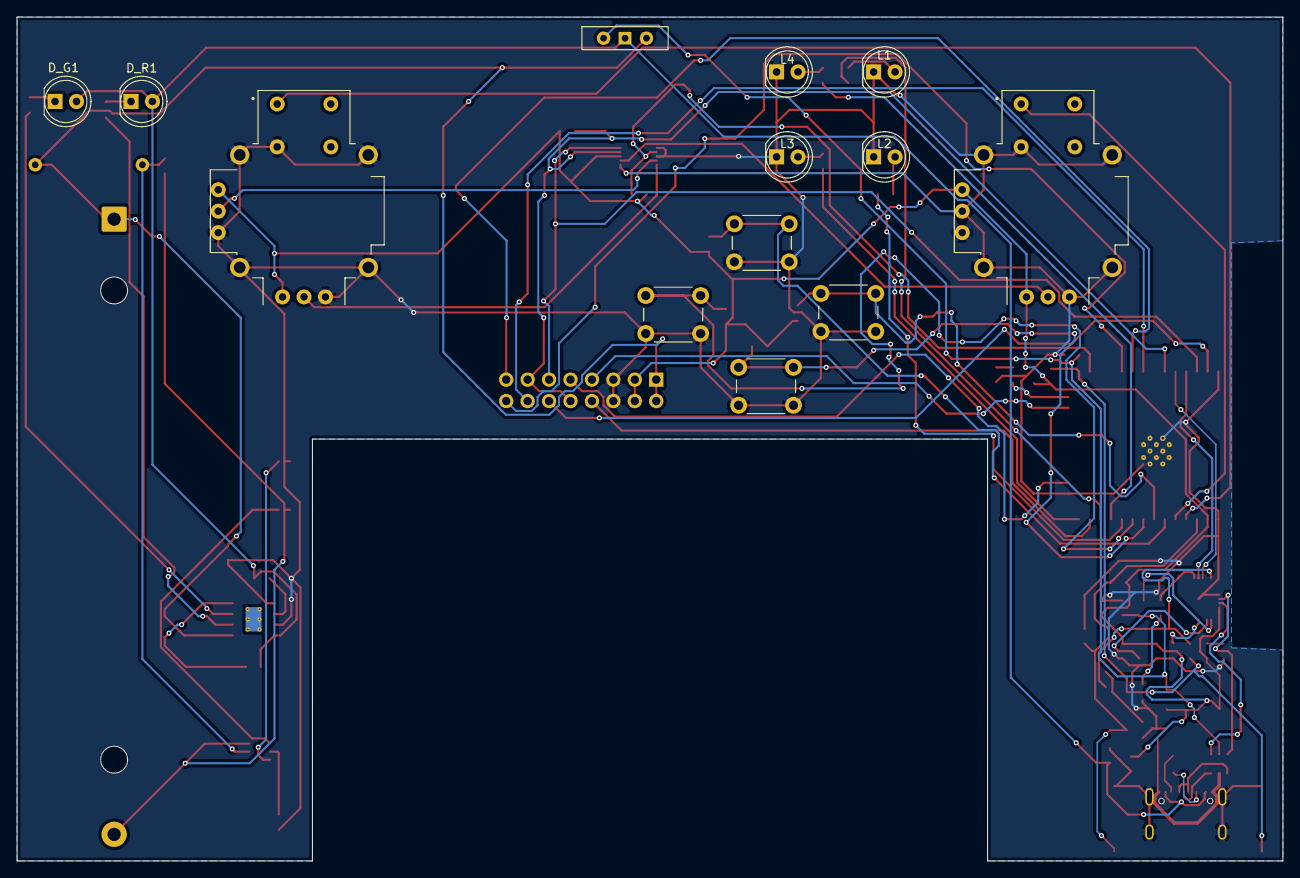
[picture p14: board ESP32 TX Board.kicad_pcb from below]

Board: 2 copper layers, 150.0 x 100.0 mm, 71 parts (13 on the bottom side), 64 nets.
