theNeonTerminal/Custom-ESP32-Remote-Dev-Board/(commit log)

2026-11-11 Completed RX Board Schematic
    [ESP32 RX Board.kicad_pcb, ESP32 RX Board.kicad_sch, ESP32 TX Board.kicad_pcb, ESP32 TX Board.kicad_sch]
2026-11-11 Completed RX Board Routing
    [ESP32 RX Board-B_Cu.gbr, ESP32 RX Board-B_Mask.gbr, ESP32 RX Board-B_Paste.gbr, ESP32 RX Board-B_Silkscreen.gbr, ESP32 RX Board-Edge_Cuts.gbr, ESP32 RX Board-F_Cu.gbr, ESP32 RX Board-F_Mask.gbr, ESP32 RX Board-F_Paste.gbr]
2026-11-12 Completed TX Schematic
    [ESP32 TX Board.kicad_sch]
2026-11-13 Completed Everything :D
    [ESP32 RX Board-B_Cu.gbr, ESP32 RX Board-B_Mask.gbr, ESP32 RX Board-B_Paste.gbr, ESP32 RX Board-B_Silkscreen.gbr, ESP32 RX Board-Edge_Cuts.gbr, ESP32 RX Board-F_Cu.gbr, ESP32 RX Board-F_Mask.gbr, ESP32 RX Board-F_Paste.gbr]
